vaxdatex/Swamp/SWAMPNL2_Montaza/SWAMPNL2-layout.pdf

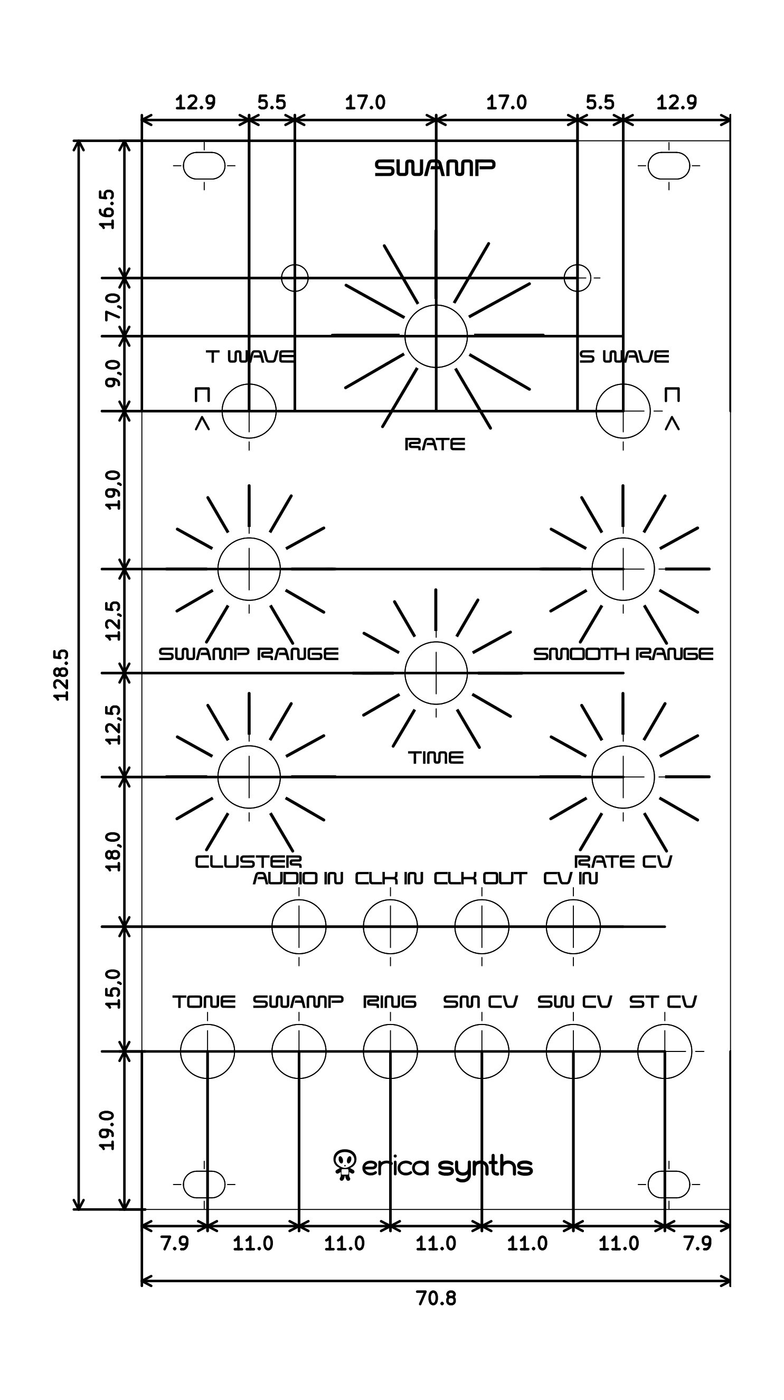
[picture p1: page 1]
