vaxdatex/Swamp/SWAMPNL2_Montaza/SWAMPNL2-layout_noDim.pdf

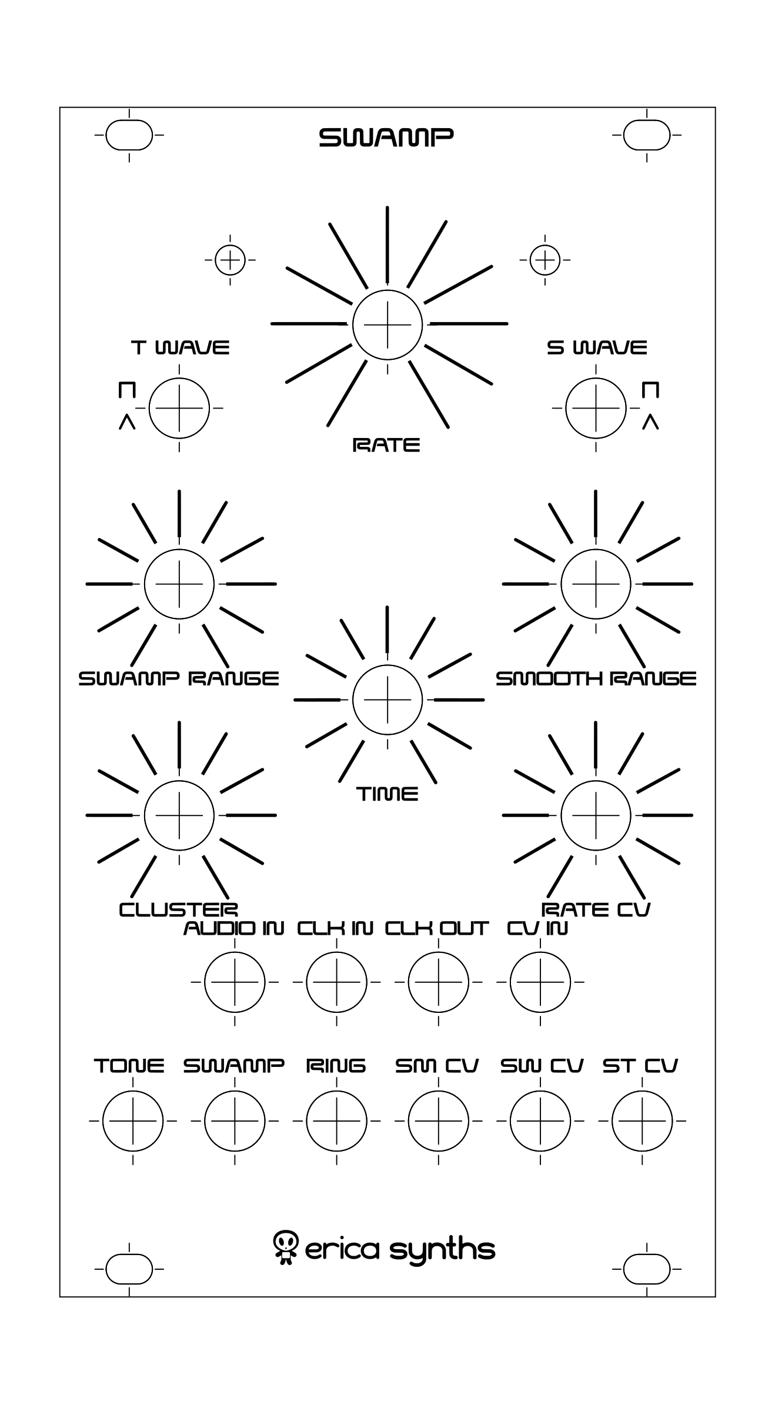
[picture p2: page 1]
