vaxdatex/Swamp/SWAMP12_Assembly/DIY_SWAMP12.pdf

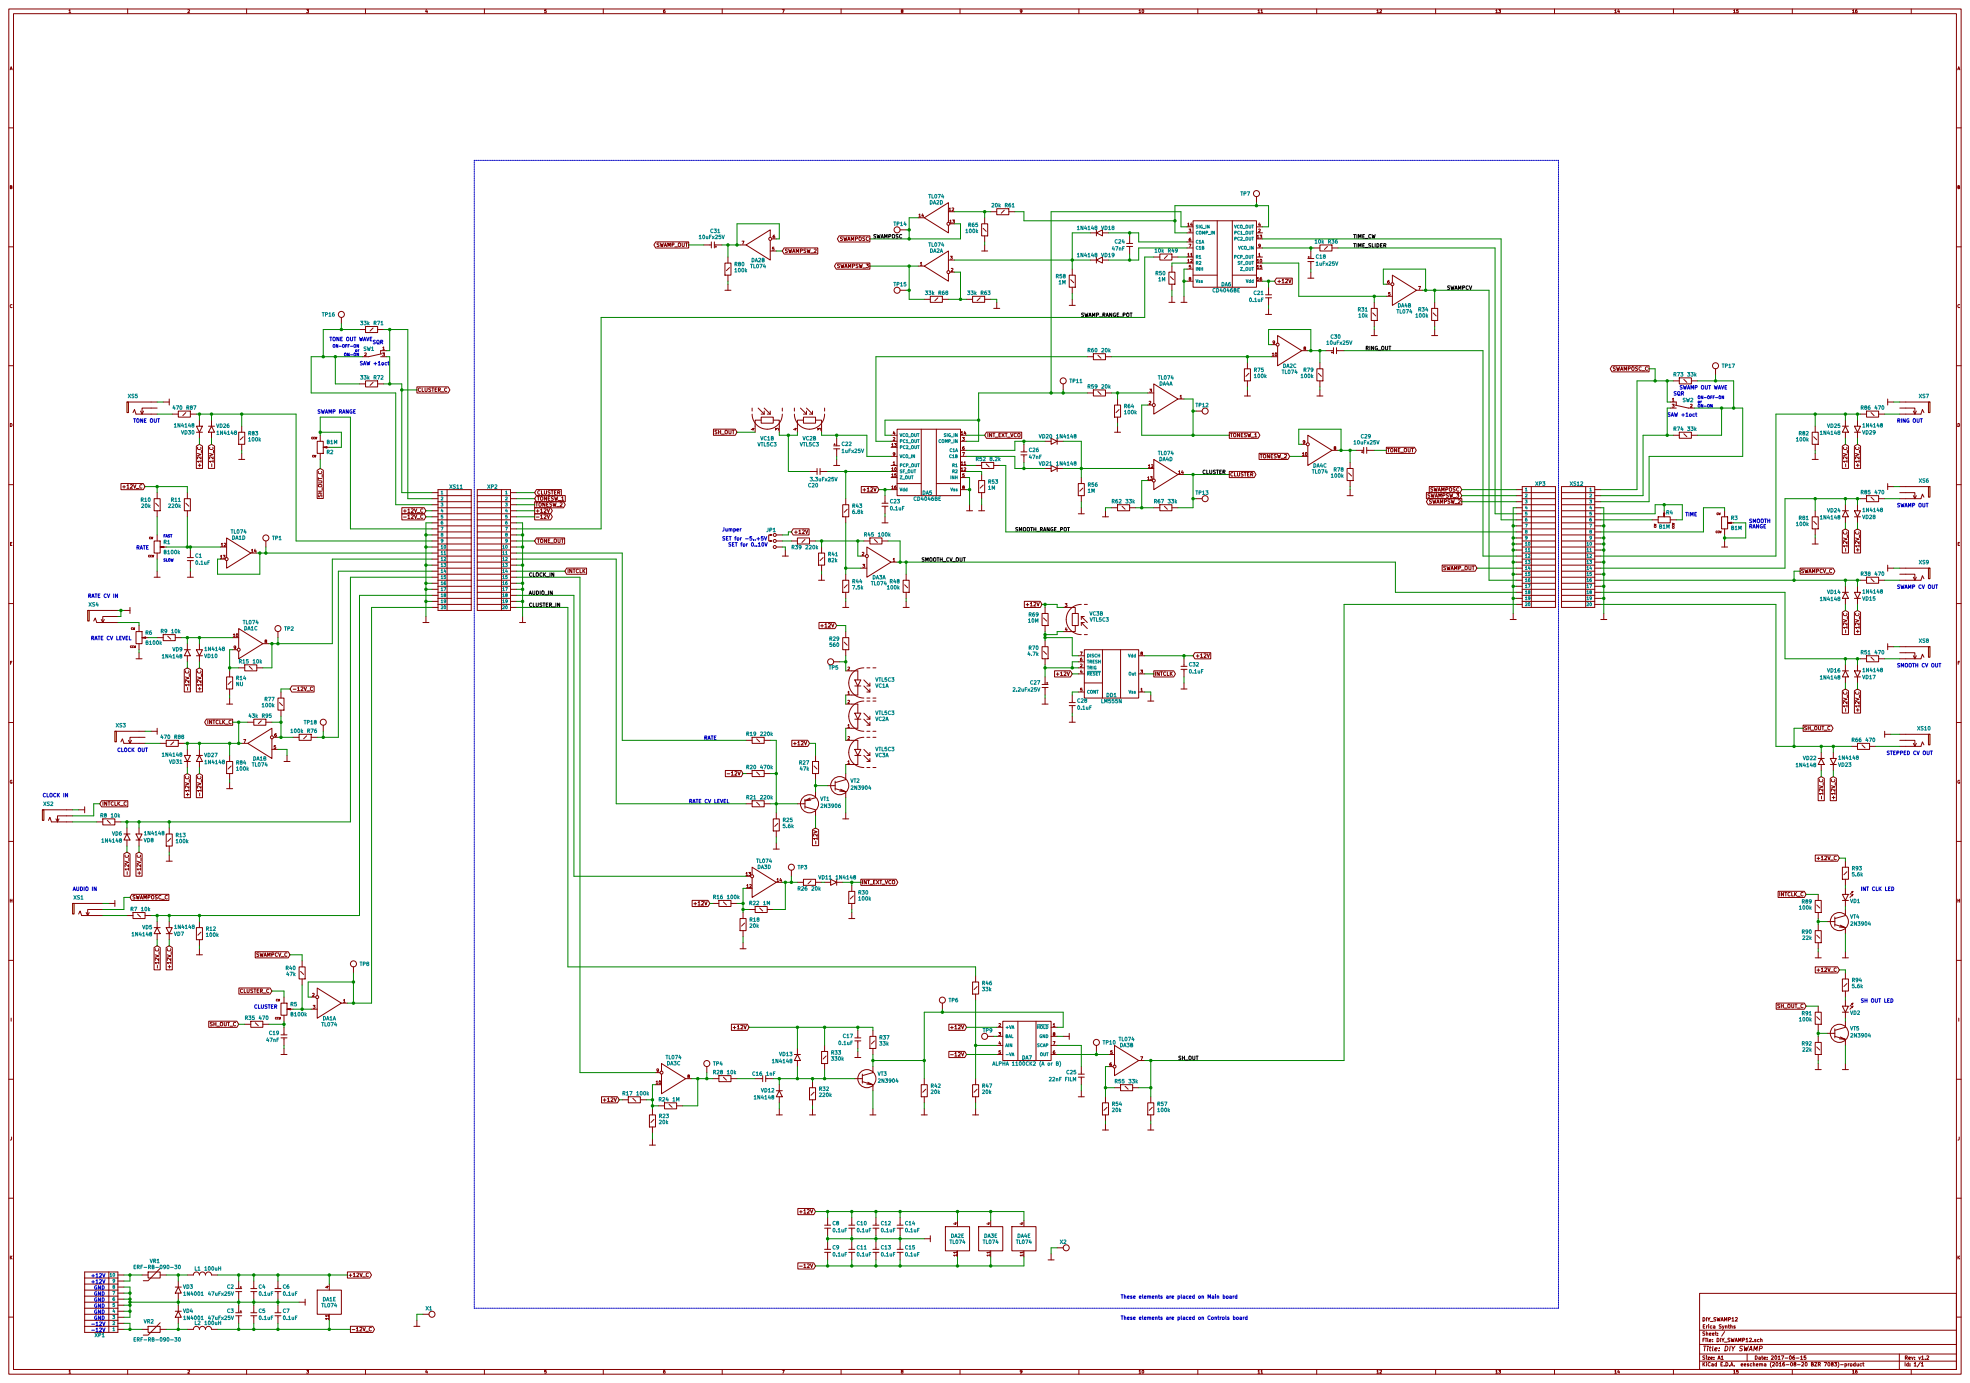
[picture p3: page 1]

SWAMP OUT WAVE
or ON-ON SQR

19 XS11 6

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
RATE RATE CV LEVEL

GND | 10 XP1 +12V 7
+12V GND | 9

GND | 6
GND | 5
GND | 4
GND | 3
-12V | 2
-12V | 1

These elements are placed on Main board

These elements are placed on Controls board

DIY_SWAMP12
File: DIY_SWAMP12.sch Sheet: / Erica Synths

Id: 1/1 Title: DIY SWAMP
